MinhKhoi175/Do-An-2/LUU DO/LUU DO HE THONG.drawio.png

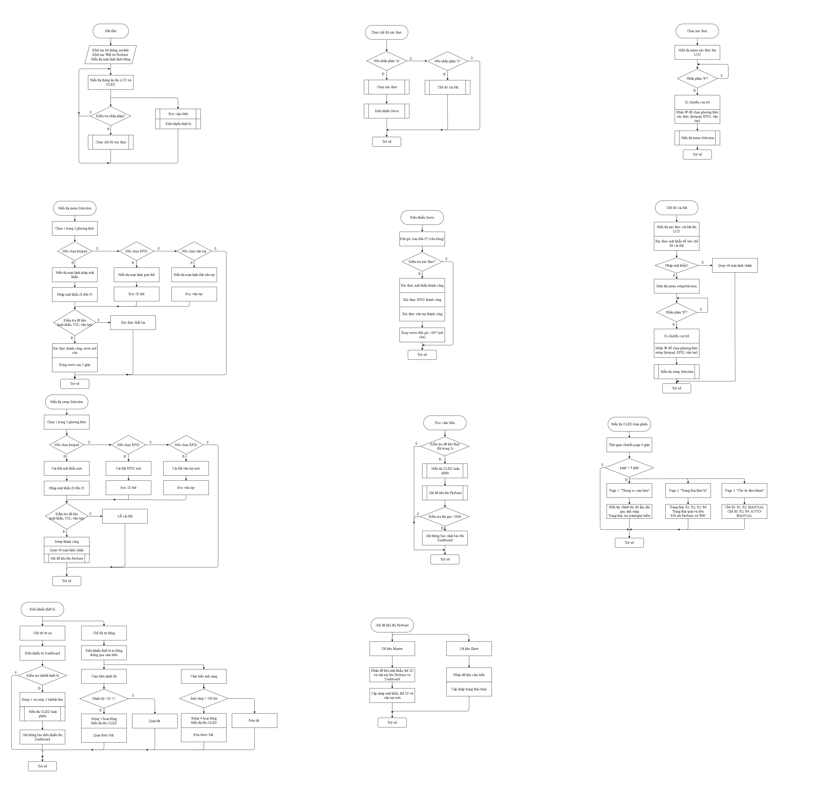
LUU DO/LUU DO HE THONG.drawio.png
