MinhKhoi175/Do-An-2/PCB_Project_Slave/Project Outputs for PCB_Project_Slave/PCB_Project_Slave.xlsx

Comment | Description | Designator | Footprint | LibRef | Quantity
BH1750FVI | Cắm | ANH SANG | JP 1x5 DT | JP 1x5 2.54 Duc Thang | 1
100uF |  | C5, C8 | 100UF/16V_SMD | Cap100uF_SMD | 2
104 | Dán | C6, C7 | tu 1206 | Tu 1206 104 50V 20% | 2
DHT22 | Cắm | DHT | JP 1x3 CT | JP 1x3 2.54 Cai Thang | 1
ESP32 SLIVE | Microcontoller Board 38 Pins Wifi 2.4GHz BLE 4.2 ESP32-WROOM-32D | ESP2 | ESP32_38 | ESP32_38 | 1
AMS1117 | IC REG LINEAR 1A SOT-89-3L | Jack DC2 | AMS1117 | AMS1117 | 1
Jac DC | Jac DC input | JDC2 | DC-IN | DCIN | 1
JP 2x2 2.54 | Cắm | JP1 | JP 2x2 DT | JP 2x2 2.54 Duc Thang | 1
OLED | Cắm | MAN HINH OLED | JP 1x4 DT | JP 1x4 2.54 Duc Thang | 1
MQ2 | Cắm | MQ2 | JP 1x4 CT | JP 1x4 2.54 Cai Thang | 1
RELAY 4 KÊNH | Cắm | RELAY 1 | JP 1x6 DC | JP 1x6 2.54 Duc Cong | 1
