MinhKhoi175/Do-An-2/LUU DO/LUU DO HE THONG.drawio.pdf

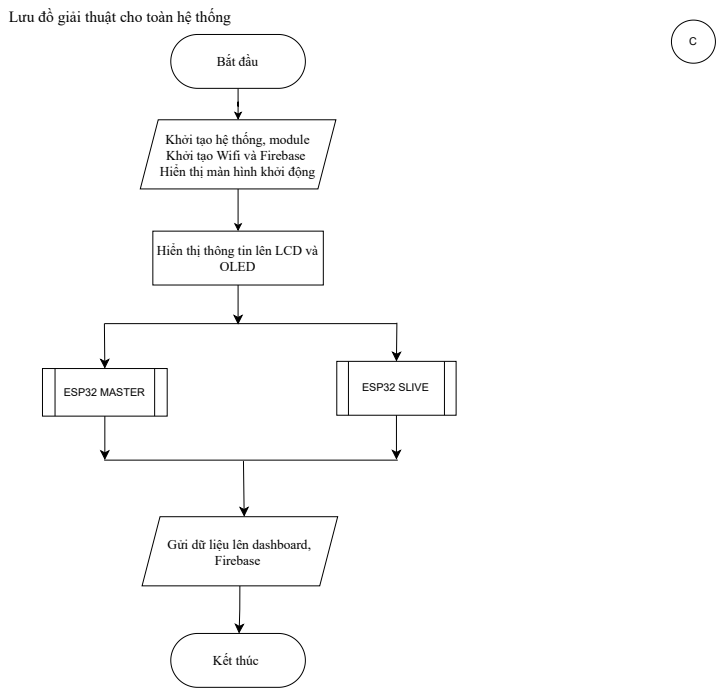
[picture p102: page 1]
Bắt đầu; OLED; Kết thúc; Firebase

Lưu đồ giải thuật cho toàn hệ thống

Khởi tạo hệ thống, module
Khởi tạo Wifi và Firebase
Hiển thị màn hình khởi động

Hiển thị thông tin lên LCD và

ESP32 SLIVE

ESP32 MASTER

Gửi dữ liệu lên dashboard,

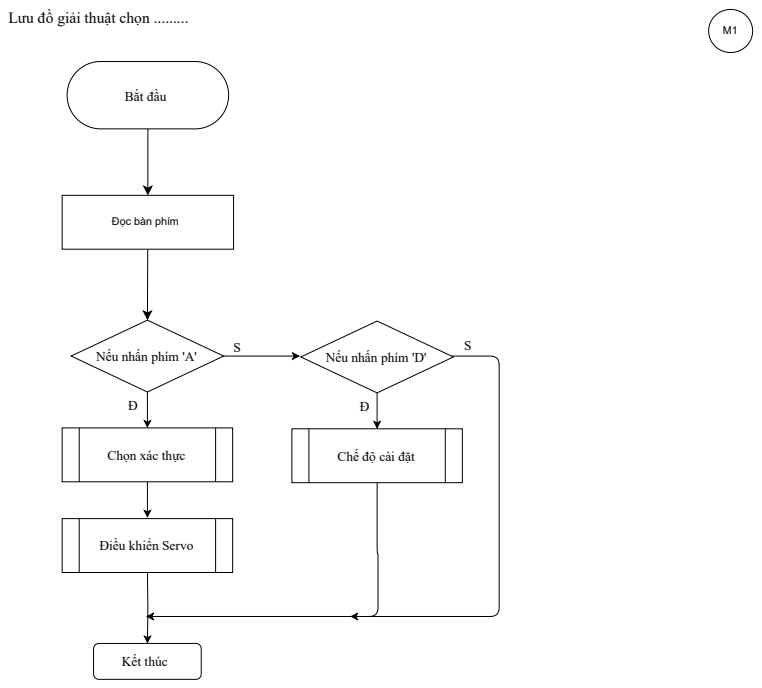
[picture p103: page 2]
Bắt đầu; Nếu nhấn phím 'A'; Nếu nhấn phím 'D'; Chọn xác thực; Chế độ cài đặt; Kết thúc

Lưu đồ giải thuật chọn .........

Đọc bàn phím

Điều khiển Servo

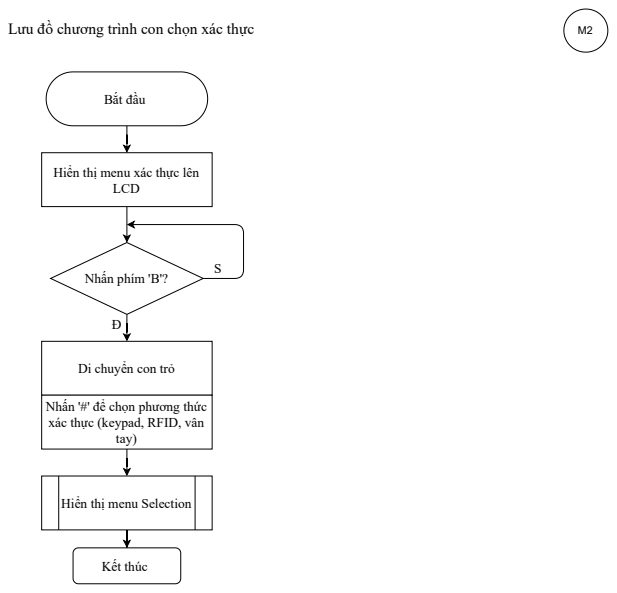
[picture p104: page 3]
Bắt đầu; LCD; Nhấn phím 'B'?; tay); Kết thúc; Lưu đồ chương trình con chọn xác thực

Hiển thị menu xác thực lên

Di chuyển con trỏ

Nhấn '#' để chọn phương thức
xác thực (keypad, RFID, vân

Hiển thị menu Selection

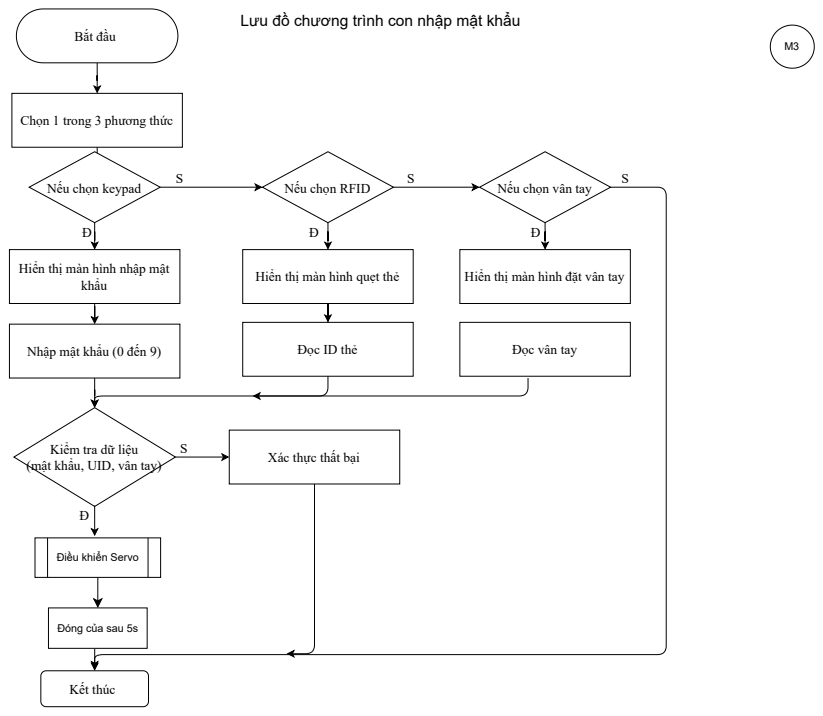
[picture p105: page 4]
Bắt đầu; khẩu; Nếu chọn RFID; Kết thúc; Xác thực thất bại

Lưu đồ chương trình con nhập mật khẩu

Chọn 1 trong 3 phương thức

Nếu chọn keypad

Nếu chọn vân tay

Hiển thị màn hình nhập mật

Hiển thị màn hình quẹt thẻ

Hiển thị màn hình đặt vân tay

Nhập mật khẩu (0 đến 9)

Đọc ID thẻ

Đọc vân tay

Kiểm tra dữ liệu
(mật khẩu, UID, vân tay)

Điều khiển Servo

Đóng của sau 5s

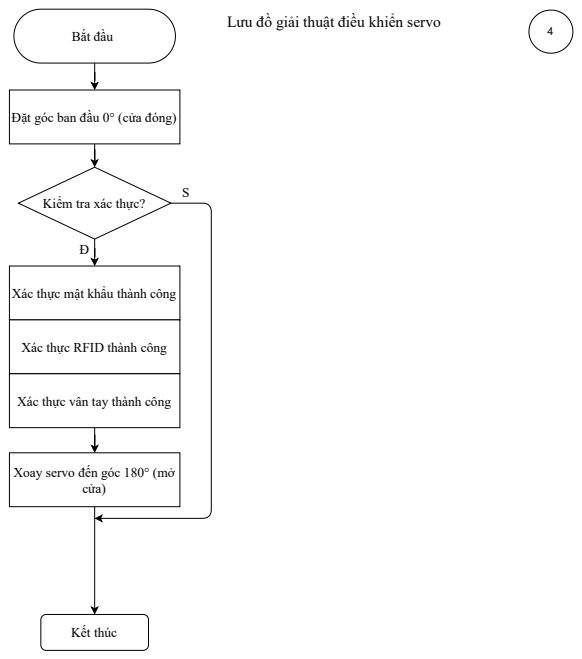
[picture p106: page 5]
Bắt đầu; Kết thúc; cửa)

Lưu đồ giải thuật điều khiển servo

Đặt góc ban đầu 0° (cửa đóng)

Kiểm tra xác thực?

Xác thực mật khẩu thành công

Xác thực RFID thành công

Xác thực vân tay thành công

Xoay servo đến góc 180° (mở

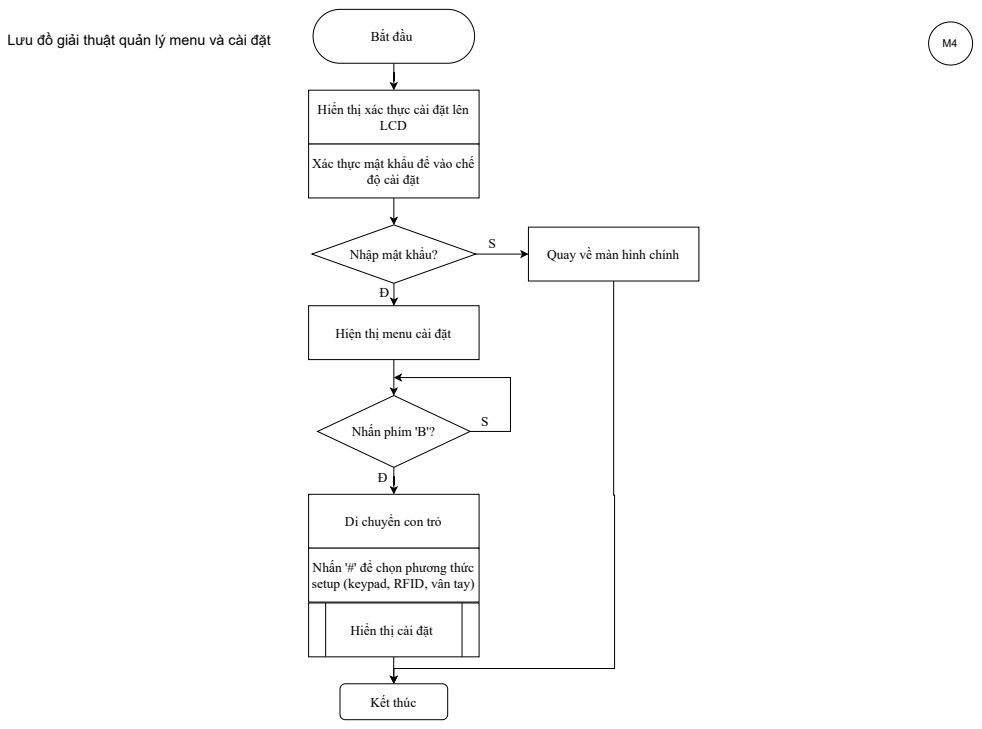
[picture p107: page 6]
Bắt đầu; LCD; Nhấn phím 'B'?; Kết thúc; Lưu đồ giải thuật quản lý menu và cài đặt

Hiển thị xác thực cài đặt lên

Xác thực mật khẩu để vào chế

độ cài đặt

Quay về màn hình chính S

Nhập mật khẩu?

Hiện thị menu cài đặt

Di chuyển con trỏ

Nhấn '#' để chọn phương thức
setup (keypad, RFID, vân tay)

Hiển thị cài đặt

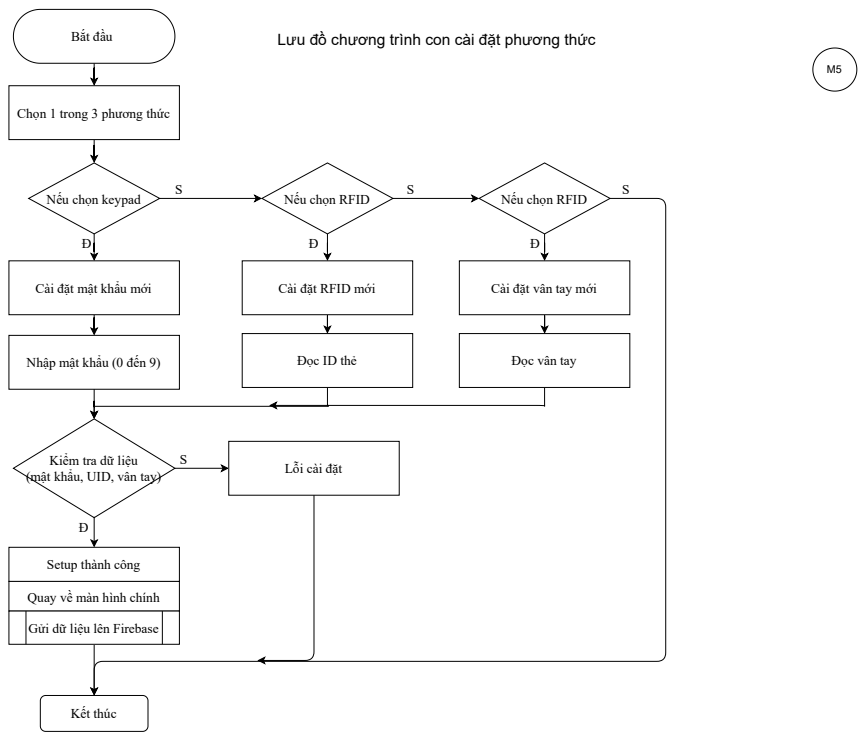
[picture p108: page 7]
Bắt đầu; Nếu chọn RFID; Kết thúc

Lưu đồ chương trình con cài đặt phương thức

Chọn 1 trong 3 phương thức

Nếu chọn keypad

Nếu chọn RFID

Cài đặt mật khẩu mới

Cài đặt RFID mới

Cài đặt vân tay mới

Nhập mật khẩu (0 đến 9)

Đọc ID thẻ

Đọc vân tay

Kiểm tra dữ liệu
(mật khẩu, UID, vân tay)

Lỗi cài đặt

Setup thành công

Quay về màn hình chính

Gửi dữ liệu lên Firebase

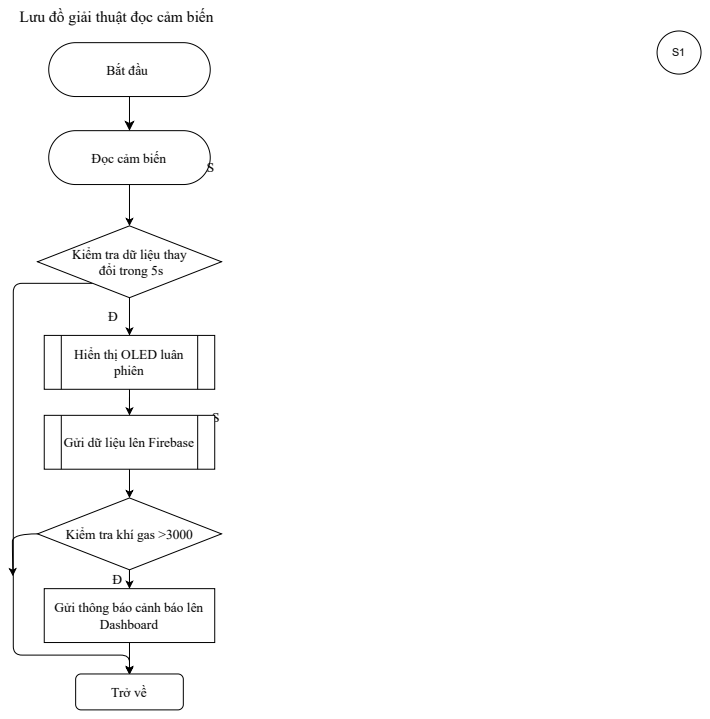
[picture p109: page 8]
Dashboard; Trở về; Bắt đầu

Lưu đồ giải thuật đọc cảm biến

Đọc cảm biến

Kiểm tra dữ liệu thay
đổi trong 5s

Hiển thị OLED luân
phiên

Gửi dữ liệu lên Firebase

Kiểm tra khí gas >3000

Gửi thông báo cảnh báo lên

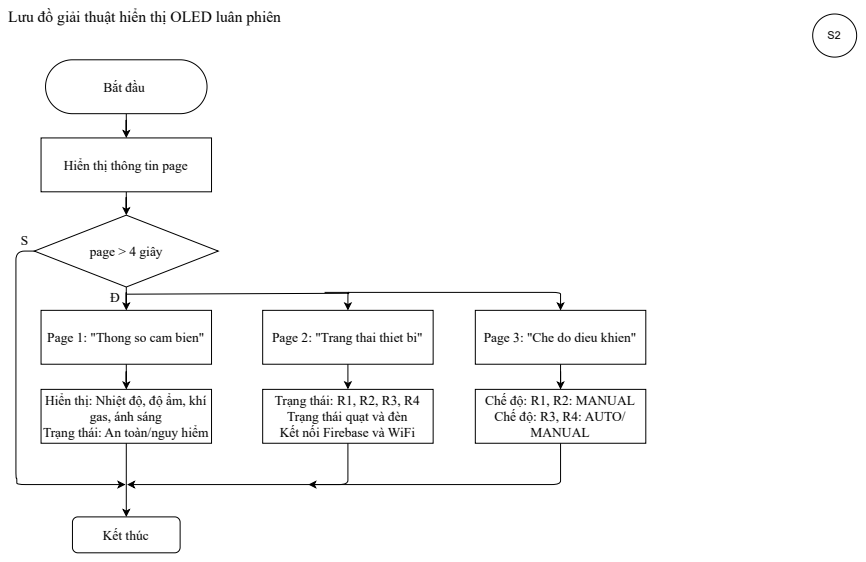
[picture p110: page 9]
Bắt đầu; page > 4 giây; Page 1: "Thong so cam bien"; Page 2: "Trang thai thiet bi"; Page 3: "Che do dieu khien"; Kết thúc

Lưu đồ giải thuật hiển thị OLED luân phiên

Hiển thị thông tin page

Hiển thị: Nhiệt độ, độ ẩm, khí
gas, ánh sáng

Trạng thái: R1, R2, R3, R4
Trạng thái quạt và đèn
Kết nối Firebase và WiFi

Chế độ: R1, R2: MANUAL
Chế độ: R3, R4: AUTO/
MANUAL

Trạng thái: An toàn/nguy hiểm

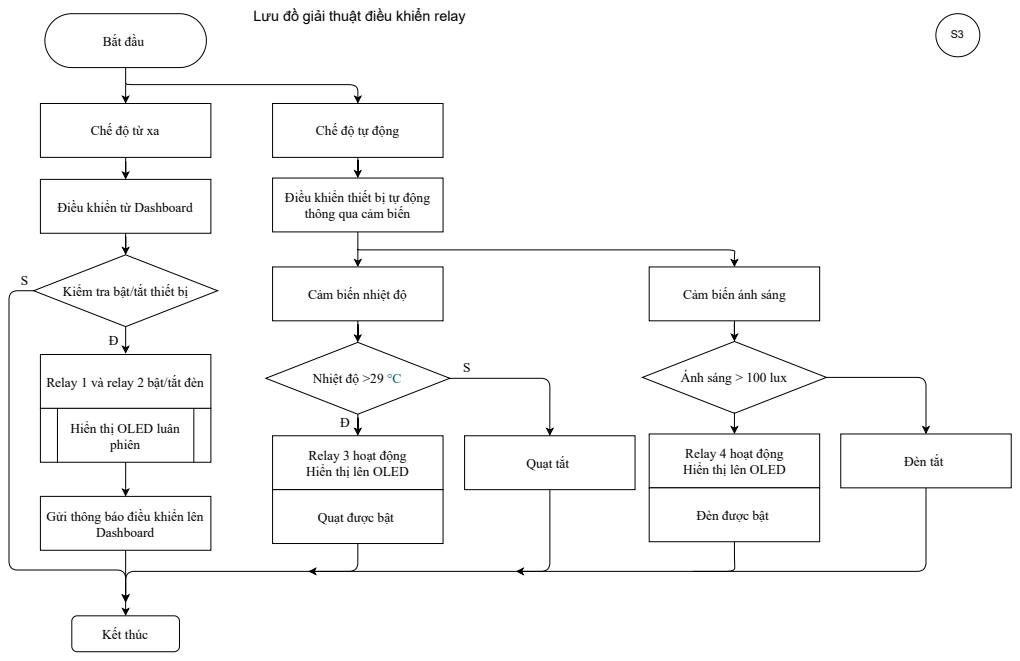
[picture p111: page 10]
Bắt đầu; Dashboard; Kết thúc; Nhiệt độ >29 °C; Cảm biến nhiệt độ; Cảm biến ánh sáng; Quạt tắt; Đèn tắt

Lưu đồ giải thuật điều khiển relay

Chế độ từ xa

Chế độ tự động

Điều khiển thiết bị tự động
thông qua cảm biến

Điều khiển từ Dashboard

Kiểm tra bật/tắt thiết bị

Ánh sáng > 100 lux

Relay 1 và relay 2 bật/tắt đèn

Hiển thị OLED luân
phiên

Relay 3 hoạt động
Hiển thị lên OLED

Relay 4 hoạt động

Gửi thông báo điều khiển lên

Quạt được bật

Đèn được bật

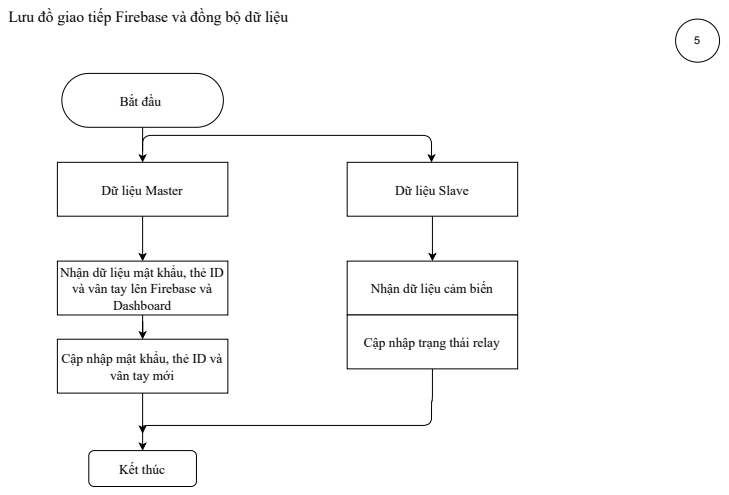
[picture p112: page 11]
Bắt đầu; Dữ liệu Master; Dữ liệu Slave; Kết thúc

Lưu đồ giao tiếp Firebase và đồng bộ dữ liệu

Nhận dữ liệu mật khẩu, thẻ ID
và vân tay lên Firebase và
Dashboard

Nhận dữ liệu cảm biến

Cập nhập trạng thái relay

Cập nhập mật khẩu, thẻ ID và

vân tay mới

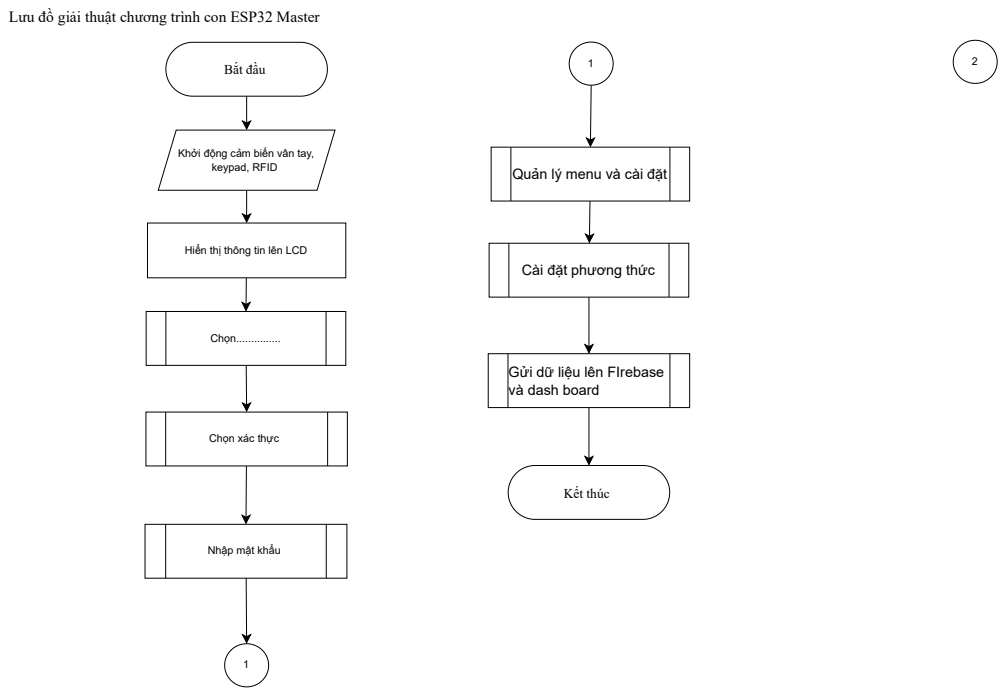
[picture p113: page 12]
Bắt đầu; Chọn...............; Kết thúc

Lưu đồ giải thuật chương trình con ESP32 Master

Khởi động cảm biến vân tay,
keypad, RFID

Quản lý menu và cài đặt

Hiển thị thông tin lên LCD

Cài đặt phương thức

Gửi dữ liệu lên FIrebase và dash board

Chọn xác thực

Nhập mật khẩu

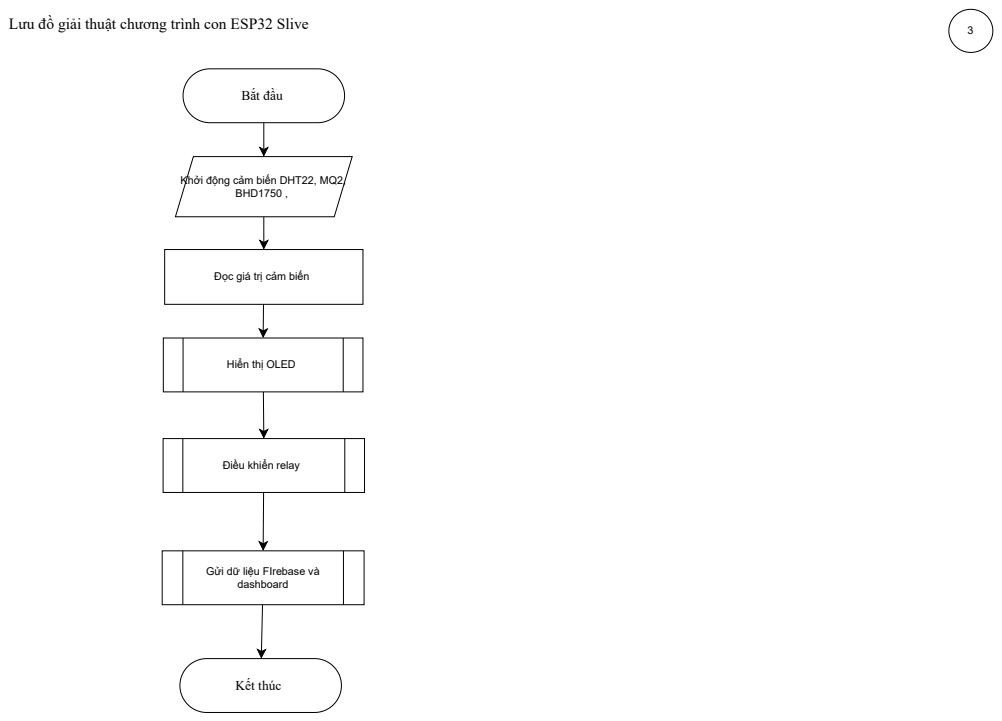
[picture p114: page 13]
Bắt đầu; BHD1750 ,; Kết thúc

Lưu đồ giải thuật chương trình con ESP32 Slive

Khởi động cảm biến DHT22, MQ2,

Đọc giá trị cảm biến

Hiển thị OLED

Điều khiển relay

Gửi dữ liệu FIrebase và
dashboard
