MinhKhoi175/Do-An-2/PCB_Project/PCB_Project.pdf

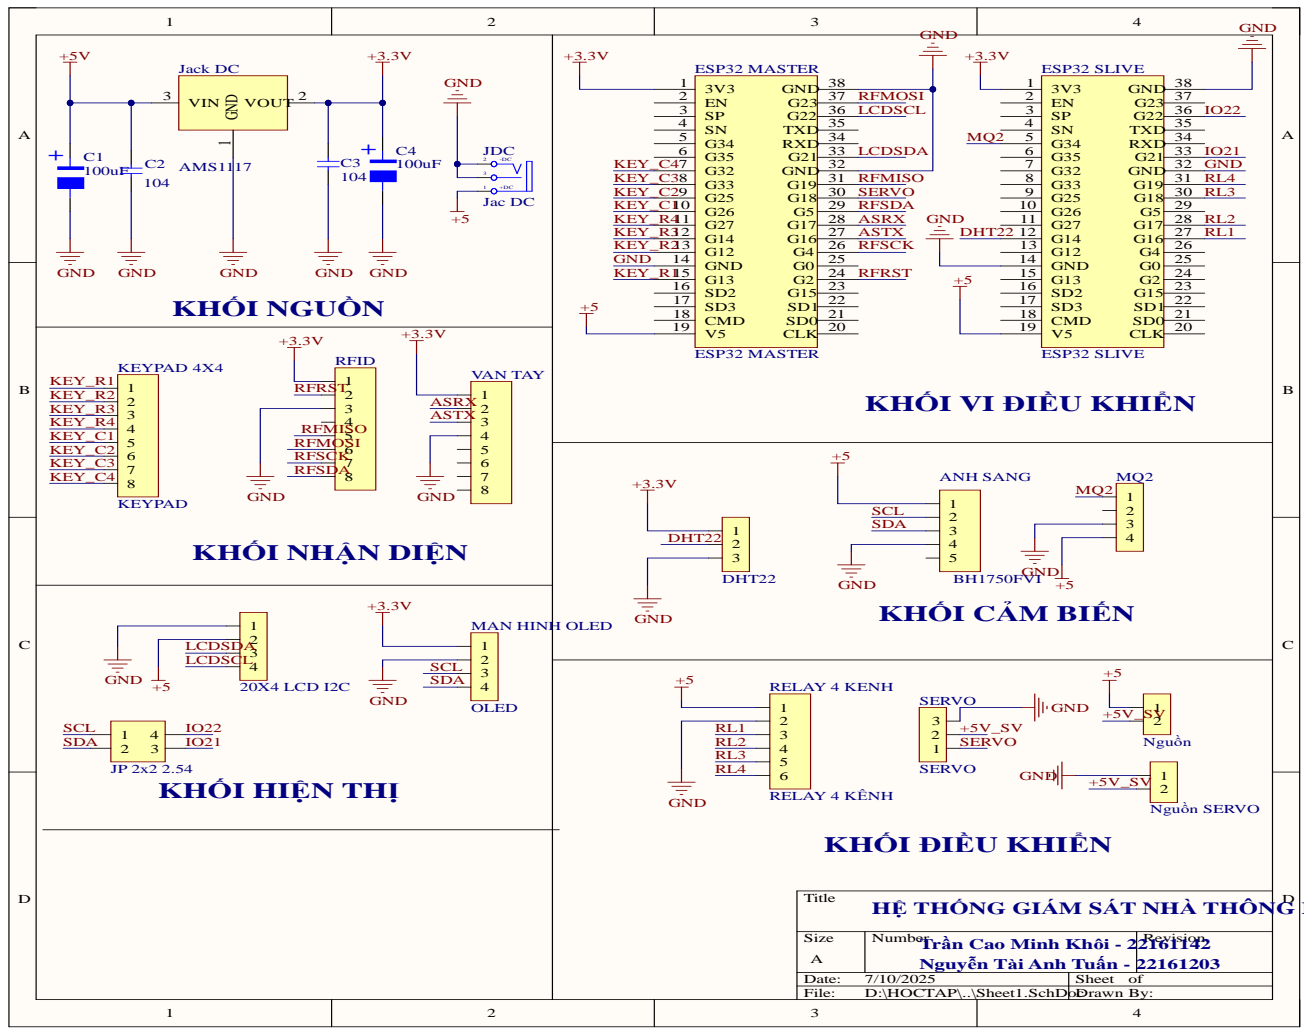
[picture p115: page 1]

KHỐI VI ĐIỀU KHIỂN

LCDSDA
LCDSCL

HỆ THỐNG GIÁM SÁT NHÀ THÔNG MINH

Trần Cao Minh Khôi - 22161142

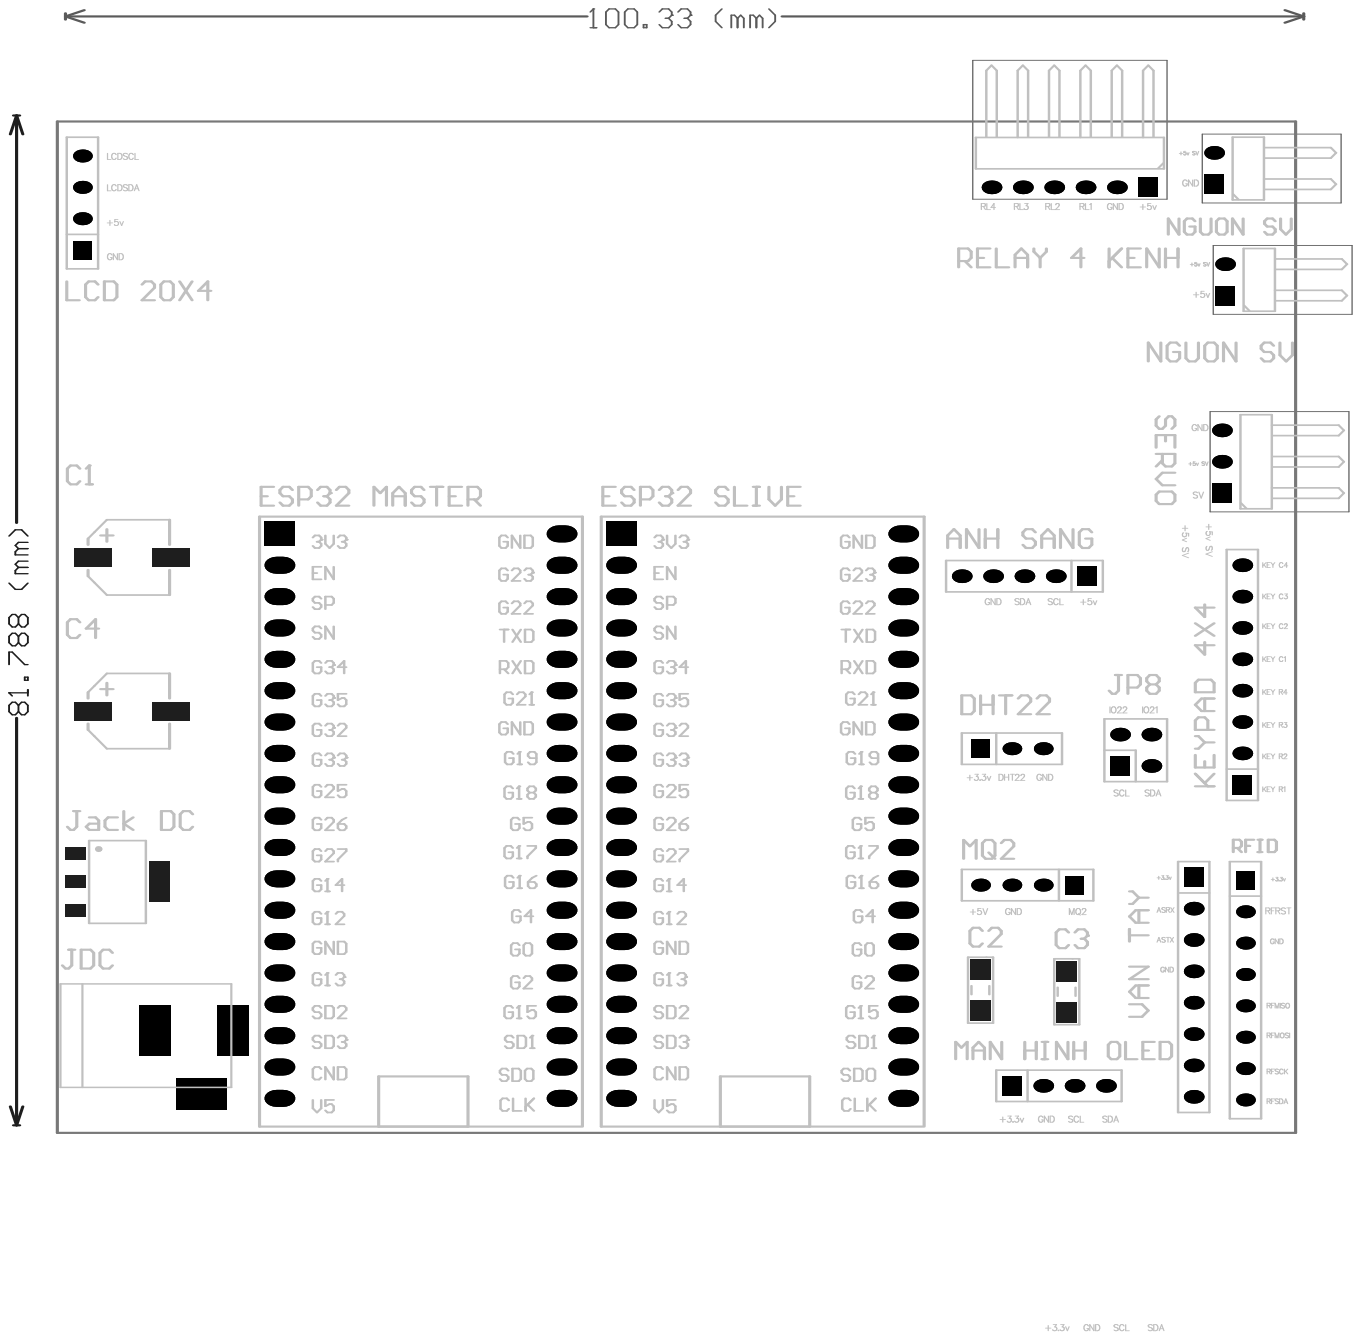
[picture p116: page 2]
