MinhKhoi175/Do-An-2/(list of files, drawings)

Other design files:
ESP32_MASTER_SLAVE/ESP32_MASTER_SLAVE/PCB_ESP32_MASTER_SLAVE.json
PCB_Project/Sheet1.SchDoc
PCB_Project/Sheet2.SchDoc
PCB_Project_Slave/PCB_Project_Slave.PrjPcb
PCB_Project_Slave/SLIVE.SchDoc
